ML-EAFIT/heat-computing-open-source/docs/01_evidence.md

# 01 — Evidence extraction

Short paper names: **DTM** = `data/An efficient probabilistic hardware architecture for diffusion-like models - 2510.23972v2.pdf`; **BP** = `data/A Blueprint for Equilibrium-Based … - 2607.16183v2.pdf`; **SDP** = `data/A Framework for Stochastic Differentiable Programming - 2608.01612v2.pdf`; **HF** = `data/Heat factorization.pdf`; **DF** = `data/Diffusion_Based_Integer_Factorization__….pdf`. Page numbers are PDF pages (see `docs/00_inventory.md`).

Extraction caveat: pdftotext drops decimal points in these PDFs (e.g. it prints "16 T nJ"). Every numeric value below that contains a decimal point was **checked against the rendered page image** (DTM p.6, p.25, p.29, p.38).

| Concept | What the sources say | Tag | Citation |
|---|---|---|---|
| **p-bit / probabilistic unit** | Each node of the grid "represents a single Bernoulli random variable x_i, implemented as a transistor-based sampling circuit (later referred to as RNG)". Its probability of producing 1 vs −1 "is constrained to be a sigmoidal function of an input voltage". | [DOCUMENTED] | [DTM, p.5, Sec. III] |
| p-bit (software type) | A pbit carries a distribution over two states; pdit over d states; pmode over ℝᴺ. | [DOCUMENTED] | [SDP, p.2, Sec. II A, Table I] |
| p-bit (X0 chip) | The X0 pbit outputs "a two-level random telegraph signal whose bias is approximately sigmoidal in a single control voltage". Controls are set via on-chip **8-bit DACs**. Per-site calibration error ≈5 % in absolute probability after Bayesian-optimization calibration. | [DOCUMENTED] | [SDP, p.20-21, App. D, Table II; p.9, Sec. IV B] |
| **Noise / RNG source** | "Our RNG is a digitizing comparator fed by a source of Gaussian noise… The mean of the Gaussian noise is shifted before it is sent into the comparator to implement the bias control." Built from shot-noise dynamics of subthreshold transistors. ~10 transistors, ~3 µm × 3 µm. | [DOCUMENTED] | [DTM, p.37, App. K; p.38, Fig. 15a; p.6, Sec. III; p.25, App. E] |
| RNG timing / energy | Autocorrelation decays approximately exponentially with τ0 ≈ 100 ns. Bits at τ_rng⁻¹ ≈ 10 MHz using ~350 aJ per bit. X0 pbit designs span τ0 ≈ 1 ns–1 ms. | [DOCUMENTED] | [DTM, p.6, Fig. 4b; p.25, App. E; SDP, p.20, App. D Eq. D1] |
| RNG transistor-level circuit | The noise-source circuit is delegated to Ref. [16] ("Taming nonequilibrium thermal fluctuations in subthreshold…"), which is **not in data/**. The transistor schematic of the noise source is therefore not available. | [NOT IN SOURCES] | [DTM, p.37, App. K cites [16]; SDP, p.15 ref list] |
| Gaussian comparator → sigmoid | A comparator thresholding shifted Gaussian noise gives a probit (Gaussian CDF) curve. The paper only says the measured curve is "well-approximated by a sigmoid". | [INFERRED] from App. K + Fig. 4a | [DTM, p.37 App. K; p.6 Fig. 4a caption] |
| **Bias & weight (coupling)** | Boltzmann-machine energy 𝓔(x) = −β(Σ_{i≠j} x_i J_ij x_j + Σ_i h_i x_i), x_i ∈ {−1,1} (β verified on the rendered page; pdftotext drops it). | [DOCUMENTED] | [DTM, p.5, Eq. 10] |
| Weight MAC in hardware | "A linear resistor network computes a biasing voltage given the sign-corrected neighbor states y_n = x_n ⊕ s_n". Conductances G_j set the weight magnitudes, and the sign bit s_j (XOR) sets the weight sign. Two fixed inputs (y=1, y=0) implement the bias term. V_b∞ = Σ G_j V_dd y_j / G_Σ, τ_bias = C/G_Σ. | [DOCUMENTED] | [DTM, p.25, Fig. 10; p.26, App. E.1, Eqs. E1-E7] |
| Weight storage | Model parameters must be stored in on-chip memory to set the tunable resistors; "tunable resistors do not exist", so real bias circuits are more complicated. | [DOCUMENTED] | [DTM, p.30, App. E.5 a] |
| Z1 coupling | Z1 "hardwires a degree-16 sparse interaction graph directly in silicon and executes chromatic Gibbs sweeps without FPGA mediation, communicating only h_i and J_ij between sweeps". | [DOCUMENTED] | [SDP, p.9-10, Fig. 7] |
| **Sigmoid / activation** | P(X_i[k+1]=+1 \| X[k]=x) = σ(2β(Σ_{j≠i} J_ij x_j + h_i)). | [DOCUMENTED] | [DTM, p.5, Eq. 11 (rendered page)] |
| Sigmoid (software) | P(s_i=1 \| s_nb) = σ[2γ], γ = W⁽¹⁾_i + Σ W⁽²⁾_ij s_j + … "computing simple functions of the neighbour states, multiply-accumulating the results, and then using them to generate an appropriately biased random bit". | [DOCUMENTED] | [thrml/02_spin_models.py:L21-27] |
| Sigmoid with β | π(σ_i=1 \| σ_N(i)) = 1/(1+e^{−2βℓ_i}), ℓ_i = h_i + Σ J_ij s_j. | [DOCUMENTED] | [torx/06_ising_sampling_contrastive_divergence.py:L111-121] |
| RNG bias curve | P(x_i=1) = σ(V_b/V_s − φ). | [DOCUMENTED] | [DTM, p.26, Eq. E6] |
| **Gibbs schedule (chromatic)** | DTM Boltzmann machines are bipartite (two-colourable): sample one colour block conditioned on the other, then swap. One full iteration takes ≈2τ0. K ≈ 1000 iterations typical (training). K_mix = 250 used for energy. | [DOCUMENTED] | [DTM, p.5, Sec. III; p.6, Eq. 12; p.29, Fig. 13] |
| Chromatic Gibbs (general) | Non-neighbouring nodes update in parallel, batched by colour group (Fig. 8, 3×3 grid). | [DOCUMENTED] | [DTM, p.20-21, App. C, Eq. C1-C2, Fig. 8] |
| Colouring in software | DSATUR greedy colouring into Blocks (thrml). Parity colouring of a ring (torx/06). Checkerboard on a 4×4 torus (torx/16). | [DOCUMENTED] | [thrml/02_spin_models.py:L129-160; torx/06_ising_sampling_contrastive_divergence.py:L198-208; torx/helpers/_plots_schematics.py:L1668-1674] |
| Clocking | "In practice, it is more efficient to implement standard chromatic Gibbs sampling with a global clock." The RNG "processes freely when the clock is low and latches to a state when the clock is high", then broadcasts to neighbours. | [DOCUMENTED] | [DTM, p.28, App. E.3 a; p.25, Fig. 10] |
| **Energy function** | P(x;θ) ∝ e^{−E(x,θ)} (EBM). Factorized local EBMs E = Σ ψ(·) are what the hardware samples. | [DOCUMENTED] | [DTM, p.2, Eq. 1; thrml/00_probabilistic_computing.py:L25-47] |
| Higher-order factors | thrml supports spin interactions of arbitrary order (SpinEBMFactor). | [DOCUMENTED] | [thrml/02_spin_models.py:L13, L300-304] |
| **Annealing / temperature** | Simulated annealing: log-spaced β from 0.1 to 8.0 over 4000 steps, 10 sweeps per step. "Raising β is the same as scaling the energy by β… scaling all the weights by β." | [DOCUMENTED] | [thrml/03_codon_optimization.py:L303-344] |
| Temperature sweep | 4×4 Ising cooled across β, order parameter vs exact. drive_i = β b_i and j = βJ are passed to the kernel. | [DOCUMENTED] | [torx/16_gibbs_sampling_factor_graph.py:L172-182, L592] |
| Temperature in hardware | The DTM hardware does not describe a β knob. β is absorbed into the programmed J, h (Eq. 10-11 carry a global β, but no hardware knob for it is described). The Blueprint's superconducting device tunes equilibration via temperature and potential. | [INFERRED] from DTM Eq. 11 and thrml/03 | [DTM, p.5, Eq. 11; thrml/03_codon_optimization.py:L311; BP, p.18, Sec. VIII] |
| **Readout** | Each cell supports get/set state. Initialization and readout send bits over long wires to the chip edge (E_init, E_read). Readout is a sample. Drawing it does not alter the distribution. | [DOCUMENTED] | [DTM, p.25 Fig. 10; p.28, App. E.3 b; SDP, p.17-18, App. B] |
| Readout estimators | Histograms and expectations from raw samples concentrate at a 1/√N rate. | [DOCUMENTED] | [torx/04_execution_interface_readouts.py:L98-118, L251, L321] |
| Readout via averaging | Expected values f(z) = E_{y∼π(·\|z)}[y] obtained by time-averaging or repeated runs (mean estimator Eq. 13). | [DOCUMENTED] | [BP, p.4, Sec. II D, Eqs. 12-14] |
| **Diffusion / denoising mapping** | DTM chains T EBMs. Each models P_θ(x^{t−1}\|x^t) ∝ Σ_z exp(−(E^f_{t−1}(x^{t−1},x^t) + E^θ_{t−1}(x^{t−1},z^{t−1},θ))). | [DOCUMENTED] | [DTM, p.4, Eqs. 7-8, Fig. 3] |
| Forward coupling | For discrete diffusion, E^f is one pairwise coupling per variable. As printed: 𝓔^f_{t−1} = Σ_i (Γ_i(t)/2) x^t_i x^{t−1}_i, with Γ(t) = ln[(1+(M−1)e^{−γt})/(1−e^{−γt})] (M=2 for binary). | [DOCUMENTED] | [DTM, p.23, App. D.1, Eq. D1 (rendered page); p.16, Eqs. B15, B20] |
| Forward coupling sign | Eq. B20 gives Q ∝ exp(+Σ Γ δ_{x'x}) (alignment favoured), and the text says E^f "constrains x^{t−1} to stay close to x^t". With P ∝ e^{−E} (Eq. 6-7), D1 as printed would favour anti-alignment. We therefore treat the effective coupling as **ferromagnetic, +Γ/2 on x^t x^{t−1} in the log-probability**. This reads the printed sign as a convention slip. | [INFERRED] | [DTM, p.4, Eqs. 6-7 and text; p.16, Eq. B20; p.23, Eq. D1] |
| DTCA grid | L×L grid (L=70), G12 connectivity: each connection rule (a,b) connects (x+a,y+b), (x−b,y+a), (x−a,y−b), (x+b,y−a). Random subset are data nodes x^{t−1} (N_data=834 of 4900), the rest latent. An extra node carrying x^t is attached to each data node and **stays fixed** during Gibbs. | [DOCUMENTED] | [DTM, p.5; p.24, Fig. 9, Table II; p.29] |
| Training | Monte Carlo gradient with clamped vs free phases (Eq. 14) and a total-correlation penalty (Eq. 15). Training is done on GPU simulation. | [DOCUMENTED] | [DTM, p.7, Sec. IV, Eqs. 14-15] |
| Per-pixel denoising in torx | nb07: an offline UNet supplies clean-pixel probabilities, and each pixel is one PNOT draw. **The denoiser is a NN, not an EBM.** | [DOCUMENTED] | [torx/07_discrete_diffusion.py:L1-8; torx/helpers/_nb07_diffusion.py:L1-7] |
| **Continuous variables (Gaussian / Langevin)** | Overdamped Langevin dx_i = −∂U/∂x_i dt + √(2/β) dW. Underdamped form Eq. 8. Equilibrium π ∝ e^{−βE} (Eq. 11). Elemental potentials: Gaussian U=(x−μ)²/(2σ) and double-well U=λ1 x²(x−1)² − λ2 x. | [DOCUMENTED] | [BP, p.3, Eq. 7; p.4, Eqs. 8-11; p.6, Eqs. 19-20] |
| Double-well ≈ p-bit | "a double well thermodynamic neuron can be converted into a probabilistic-bit". Implemented with superconducting Josephson-junction circuits; ambient thermal fluctuations are the noise. | [DOCUMENTED] | [BP, p.18, Sec. VIII] |
| Gaussian-Bernoulli EBM | Continuous v_i ~ N(b_i + σ_i² Σ W_ij h_j, σ_i²). Binary h_j ~ σ(2(Σ v_i W_ij/σ_i² + c_j)). Continuous messages are costly to pass in hardware. | [DOCUMENTED] | [DTM, p.23, App. C.1 b, Eqs. C11-C13] |
| Langevin in torx | LangevinGate: x' = x − ε∇V + √(2Tε) ξ on a soft-spin quartic Ising energy, s=tanh(x). Optional MALA accept/reject. | [DOCUMENTED] | [torx/helpers/_langevin.py:L46-143; torx/12_langevin_graph_ising.py:L92-126] |
| pmode hardware | X0 pmode = network of capacitively coupled CMOS inverters (NEAT-RN). Gaussian primitive correlation time ≈1 ns, ≈15 aJ per sample. | [DOCUMENTED] | [SDP, p.20-21, App. D] |
| Gaussian gates | Affine Gaussian gate X → MX + d + ε, ε∼N(0,Δ). Ornstein–Uhlenbeck gate. | [DOCUMENTED] | [SDP, p.6, Eq. 24; p.18, App. C; torx/10_pmode_gaussian_gates.py:L166] |
| **Probabilistic gates** | PNOT(p), PSWAP(p), PCNOT(p), PReset(p), PJUMP, PDEMUX, PCopy, PIsing. All except PIsing have the form (1−p)I + pB. | [DOCUMENTED] | [SDP, p.6, Eqs. 18-23; p.17, App. A] |
| Logic via energy | "we can express conditional relationships between variables, such as logical AND/OR/NOT [49]" by composing energy functions. No explicit AND/OR energy is given in data/. | [DOCUMENTED] (claim) / [NOT IN SOURCES] (the specific gadget) | [BP, p.3, Sec. II A] |
| **Factorization / heat kernels** | Factor N via discrete-time heat diffusion on a graph, O((log N)²) diffusion steps. RC network C dV/dt = −LV implements heat flow. Integer prototype c_{t+1}(x) = 2c_t(x) + c_t(x b^{2^t}) + c_t(x b^{−2^t}) "for a small FPGA… a verification platform, not a fast large-integer factoring machine". | [DOCUMENTED] | [HF, p.1 abstract; DF, p.63, Sec. 17, Eq. 17.1; p.71, Sec. 19.6, Eq. 19.4] |
| Factorization hardware status | The monograph's RTL "has not been synthesized or simulated with an HDL toolchain". "No hardware speedup or manufacturing feasibility is asserted without synthesis and measurements." | [DOCUMENTED] | [DF, p.75; p.1 abstract] |
| **System platform** | XTR-0 = CPU host + FPGA + socketed X0 chip. The FPGA mediates data and control, so topology and schedule are software-defined. | [DOCUMENTED] | [SDP, p.9, Fig. 6; p.20, App. D a] |
| **Energy model** | E = T·K_mix·L²·E_cell, E_cell = E_rng + E_bias + E_clock + E_comm ≈ 2 fJ (main text). Fig. 12b breakdown: total ≈1.6 fJ, dominated by neighbour communication. DTM total ≈1.6·T nJ. ~10,000× less energy than GPU on binarized Fashion-MNIST (system-level estimate). | [DOCUMENTED] | [DTM, p.6, Eqs. 12-13; p.29, Fig. 12b; p.1 abstract] |

## Consequences for the FPGA design (all [FPGA-APPROX])

1. One p-bit = **MAC over ±J (XOR sign) + bias → sigmoid → compare with noise → latch**. This mirrors Fig. 10 of DTM [DTM, p.25]. The digital MAC needs no multiplier because x_j ∈ {−1,+1}: each term is +J or −J, which is the digital equivalent of the XOR sign-correction y = x ⊕ s.
2. The RNG becomes an LFSR (pseudo-random uniform word). The Gaussian-comparator physics [DTM, p.37] becomes `rand < sigmoid(logit)`, an inverse-CDF comparison. The two give the same Bernoulli law when the LUT holds the exact target probability.
3. Chromatic (2-colour) scheduling as in DTM/torx. Our FPGA time-multiplexes the p-bit cell instead of having one physical cell per node.
4. β is handled as in thrml/03: a schedule multiplies the local field before the sigmoid.
5. The denoising demo is **feasible** at toy scale. DTM gives the forward coupling Γ(t)/2 and the clamped x^t nodes. It does **not** give trained weights for small grids, so the marginal-energy weights in our demo are hand-set (Hebbian pattern storage). That is an [FPGA-APPROX] choice, not Extropic's model.
