ML-EAFIT/heat-computing-open-source/task.md

Has ingenieria inversa de que pasa detras de un computador termodinamico de extropic

creame un codigo en verilog para testiarlo
dame las unidades basicas, por ejemplo en computacion normal son las compuertas and or not, cuales son en termodinamica, hay blqoues como alu, flip flops, cuales son en computacion termica

Dame los diagramas de cada bloque, como se conectan los bloques termodinamicos

dame un codigo en verilog usando cada bloque ,

la idea despues es meter esto en una fpga tang nano 9, sabiendo lo que hacemos
