ML-EAFIT/heat-computing-open-source/docs/img/hist_grid16.png

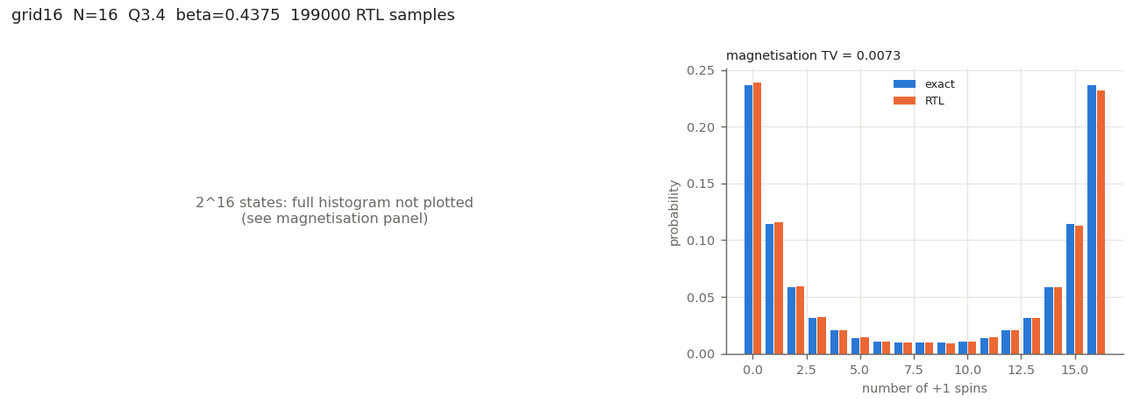
docs/img/hist_grid16.png
