ML-EAFIT/heat-computing-open-source/docs/img/hist_ring8.png

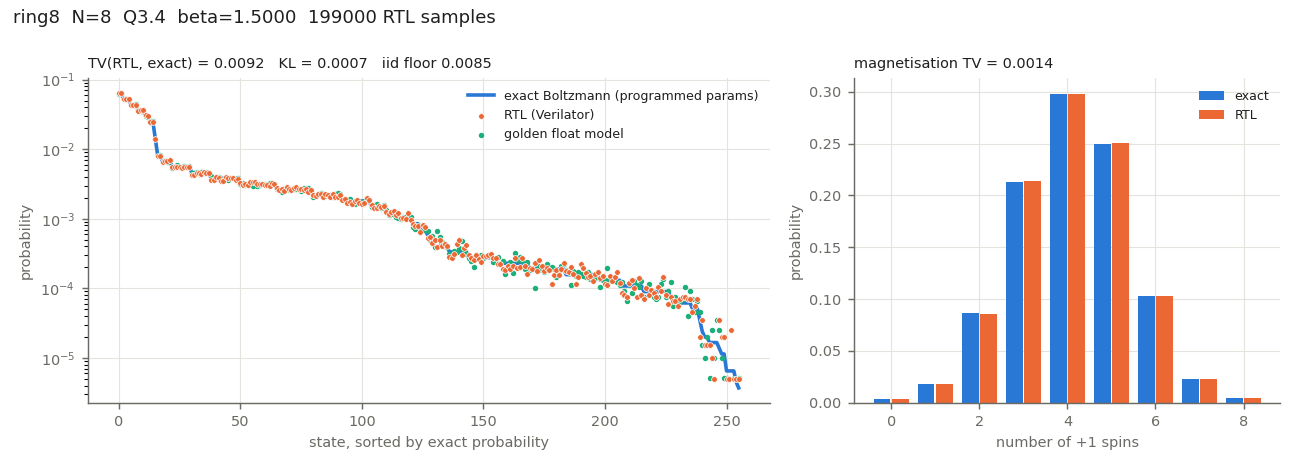
docs/img/hist_ring8.png
