ML-EAFIT/heat-computing-open-source/docs/img/pgate_fulladder.png

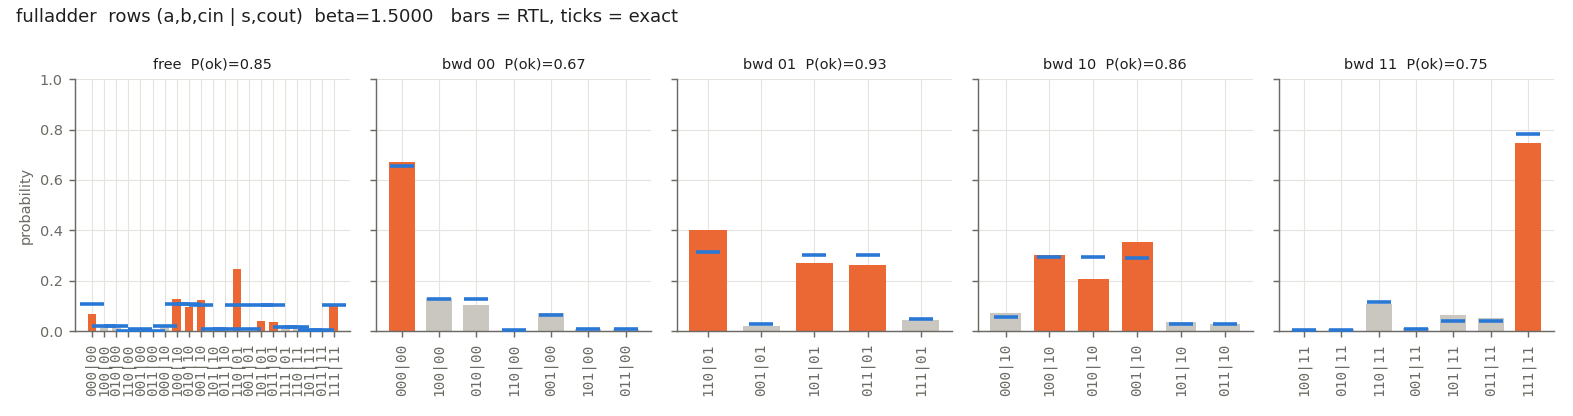
docs/img/pgate_fulladder.png
