ML-EAFIT/heat-computing-open-source/docs/img/pgate_xor.png

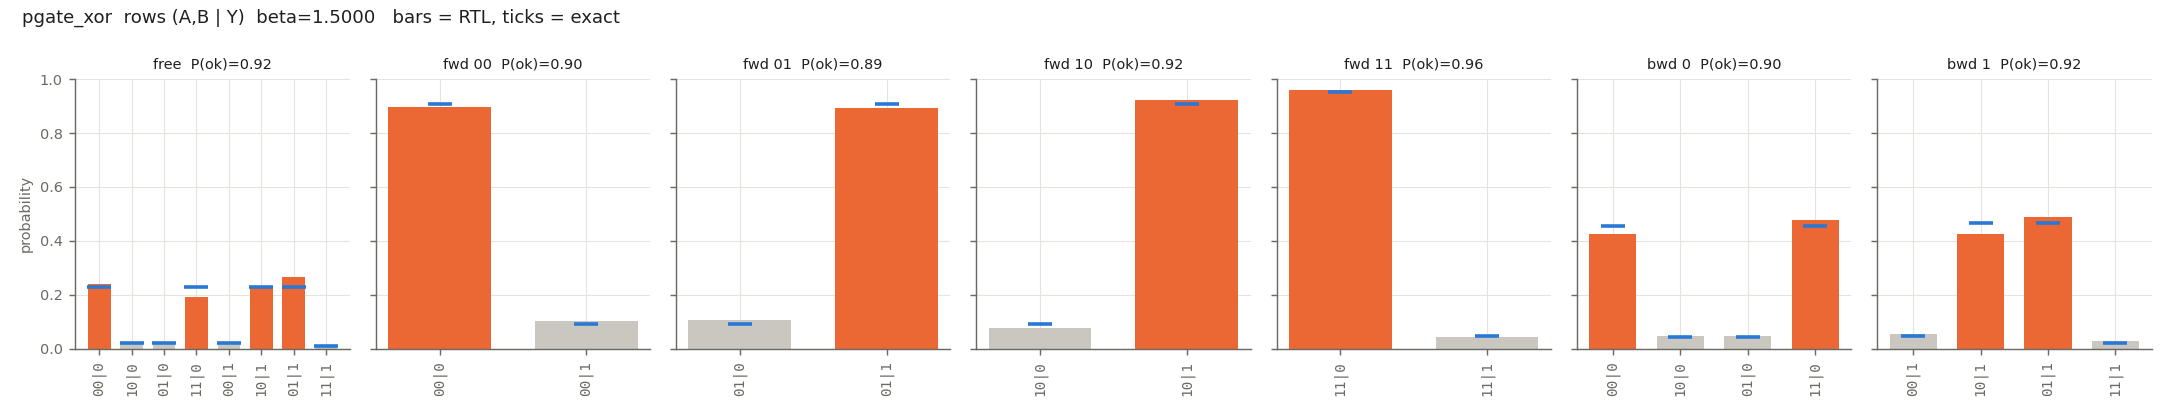
docs/img/pgate_xor.png
