ML-EAFIT/heat-computing-open-source/docs/02_building_blocks.md

# 02 — Building blocks: classical ↔ thermodynamic

Short paper names as in `docs/01_evidence.md` (DTM, BP, SDP, HF, DF).

## 1. Mapping table

| Classical block | Thermodynamic / probabilistic counterpart | What it does | Physical implementation per the sources | FPGA equivalent (this repo) |
|---|---|---|---|---|
| NOT / AND / OR gate (deterministic Boolean map) | **Probabilistic gates**: PNOT(p), PCNOT(p), PSWAP(p), PReset(p), PCopy(p), PIsing(θ). Each is a stochastic matrix, (1−p)I + pB [DOCUMENTED, SDP p.6 Eqs. 18-20; p.17 App. A]. At p∈{0,1} they reduce to deterministic gates [DOCUMENTED, SDP p.17]. | Transforms a probability distribution, not a value. | On XTR-0 the FPGA routes register values according to the outcome of a pbit programmed to p [DOCUMENTED, SDP p.9 Sec. IV B]. Energy-composed AND/OR/NOT are mentioned but not specified [DOCUMENTED claim, BP p.3; gadget NOT IN SOURCES]. | **Built as p-gates** (`rtl/pgates.v`, `model/pgates.py`): p-NOT, p-AND, p-OR, p-XOR as small Ising problems whose ground states are the truth table, composable and runnable backwards by clamping. Bit-exact vs model, truth tables verified (docs/05) [NOT IN SOURCES: standard Ising gadget coefficients]. A **p-bit with bias only** (J=0) is PNOT-from-zero with p = σ(2βh) [INFERRED from torx/06_ising_sampling_contrastive_divergence.py:L123-128]. |
| Transistor / logic cell | **p-bit (sampling cell)** | Outputs ±1 with P(+1) = σ(2β(ΣJ_ij x_j + h_i)) [DOCUMENTED, DTM p.5 Eq. 11]. | All-transistor RNG: Gaussian shot noise + control-voltage shift → comparator [DOCUMENTED, DTM p.37 App. K, p.38 Fig. 15a]. ~10 transistors, 3×3 µm [DOCUMENTED, DTM p.25]. | `rtl/pbit.v`: field → ×β → sigmoid LUT → `rand16 < p` → bit [FPGA-APPROX]. |
| Clock oscillator / entropy-free logic | **Noise source (RNG)** | Supplies fresh randomness. Decorrelation time τ0 ≈ 100 ns sets the sampling rate [DOCUMENTED, DTM p.6 Fig. 4b]. | Subthreshold-transistor shot noise [DOCUMENTED, DTM p.6]. The transistor-level noise circuit is in an external reference [NOT IN SOURCES]. | `rtl/lfsr.v`, `rtl/noise_bank.v`: 32-bit Galois LFSRs leaping 16 steps per draw. Optional ring-oscillator XOR (non-simulatable) [FPGA-APPROX]. |
| Multiplier / adder tree (ALU datapath) | **Synapse / weight MAC** (bias network) | Computes the local field ℓ_i = h_i + Σ_j J_ij x_j. | Linear resistor network. Conductance G_j sets the magnitude, and XOR with the sign bit s_j gives y_j = x_j ⊕ s_j. Two fixed inputs (1, 0) give the bias. The node relaxes with τ_bias = C/G_Σ [DOCUMENTED, DTM p.25 Fig. 10; p.26 Eqs. E1-E7]. | `rtl/weight_mac.v` / `rtl/coupling_row.v`: serial accumulate of ±J_ij (the sign of x_j selects add or subtract, **no multiplier**) [FPGA-APPROX, mirrors the XOR trick]. |
| Constant register / immediate | **Bias h_i** | Shifts a p-bit's preference. | Fixed resistor inputs y_{n+1}=1, y_{n+2}=0 [DOCUMENTED, DTM p.26]. | Bias RAM entry added as the MAC start value [FPGA-APPROX]. |
| Interconnect / bus | **Coupling network** (graph J) | Defines which p-bits see each other. | Regular grid with G8–G24 skip patterns [DOCUMENTED, DTM p.24 Table II]. Z1: hardwired degree-16 graph [DOCUMENTED, SDP p.9-10 Fig. 7]. XTR-0: topology set in software via the FPGA [DOCUMENTED, SDP p.9 Fig. 6]. | Dense N×N weight RAM in BSRAM. Zero entries mean "no edge" [FPGA-APPROX]. |
| Accumulator register | **Field accumulator** | Holds the running ℓ_i during the MAC. | Analog: the node voltage V_b on capacitor C [DOCUMENTED, DTM p.26 Eq. E1]. | Signed AW-bit register, sized so it cannot overflow [FPGA-APPROX]. |
| Comparator | **Comparator** (noise vs threshold) | Turns a continuous level into a bit. | Subthreshold comparator digitizing shifted Gaussian noise [DOCUMENTED, DTM p.37]. | `rand16 < p16` in `pbit.v` [FPGA-APPROX]. |
| Lookup / function unit | **Sigmoid (activation)** | Maps field → probability. | Intrinsic to the RNG's response to its control voltage, measured to be ≈ sigmoidal [DOCUMENTED, DTM p.6 Fig. 4a; SDP p.20 App. D]. | `rtl/sigmoid_lut.v` (1024×16 ROM in BSRAM) or `rtl/sigmoid_pwl.v` (piecewise linear, shifts only) [FPGA-APPROX]. |
| Flip-flop | **Latched spin state** | Holds x_i between updates. | The RNG "processes freely when the clock is low and latches to a state when the clock is high" [DOCUMENTED, DTM p.25 Fig. 10]. | Spin register bit `s[i]` in `pbit_array.v` [FPGA-APPROX]. |
| Clock + control FSM (program counter) | **Update scheduler** (chromatic Gibbs) | Updates colour blocks in turn. One sweep ≈ 2τ0 for a bipartite graph [DOCUMENTED, DTM p.5]. A global clock is preferred over asynchronous updates [DOCUMENTED, DTM p.28]. | Global clock tree [DOCUMENTED, DTM p.28 E.3a]. | Order ROM (colour 0 nodes, then colour 1, …). One p-bit update per slot, time-multiplexed [FPGA-APPROX]. |
| Clock frequency / voltage scaling | **Annealing controller** (β schedule) | Raises β over time to find low-energy states. | Software: log-spaced β, "scaling all the weights by β" [DOCUMENTED, thrml/03_codon_optimization.py:L311-334]. No on-chip β knob is described for DTCA [INFERRED, DTM p.5 Eq. 11]. | `rtl/schedule_ctrl.v`: constant, linear or table (geometric) β in Q4.4 [FPGA-APPROX]. |
| RAM | **Weight memory** | Stores J, h. | Parameters stored on-chip to program the resistors, with maintenance-dominated cost [DOCUMENTED, DTM p.30 E.5a]. X0 controls via 8-bit DACs [DOCUMENTED, SDP p.20]. | BSRAM, 8-bit signed Q3.4 [FPGA-APPROX]. |
| I/O port / logic analyzer | **Readout** (get/set state, histograms) | Turns samples into estimates. | get/set-state lines per cell, long wires to the chip edge [DOCUMENTED, DTM p.25 Fig. 10; p.28 E.3b]. Readout estimators concentrate as 1/√N [DOCUMENTED, torx/04_execution_interface_readouts.py:L251, L321]. | `rtl/readout_counter.v`: per-spin "up" counters + full-state histogram (N ≤ 12) [FPGA-APPROX]. |
| Host bus (PCIe, …) | **Host interface** | Programs J, h, schedule. Reads samples. | XTR-0: CPU host + FPGA + chip [DOCUMENTED, SDP p.9 Fig. 6]. Z1: host sends h_i, J_ij between sweeps [DOCUMENTED, SDP p.9]. | `rtl/uart_rx.v`, `rtl/uart_tx.v`, command FSM in `rtl/top.v` (115200 8N1 over the Tang Nano's BL702 USB-UART) [FPGA-APPROX]. |
| Analog-domain primitive (op-amp integrator) | **pmode / Langevin node** (continuous variable) | Gaussian or double-well variable relaxing under Langevin dynamics [DOCUMENTED, BP p.3 Eq. 7; p.6 Eqs. 19-20]. | Superconducting double-well "thermodynamic neuron" [DOCUMENTED, BP p.18]. X0 pmode = capacitively coupled CMOS inverters (NEAT-RN) [DOCUMENTED, SDP p.21]. | **Built** (2026-10-30): `rtl/pmode_array.v`, M ≤ 16 Langevin soft spins x' = x − ε∇V + √(2Tε)ξ, the torx `LangevinGate` energy with tanh from the p-bit sigmoid LUT and ξ from an inverse-CDF Gaussian table. Bit-exact with `model/pmode.py`, histograms vs exact e^{−V/T} in docs/06 §11 [FPGA-APPROX: fixed point, ULA without Metropolis]. |
| Swap / exchange unit (no classical twin; closest is a speculative-execution select) | **Replica exchange** (parallel tempering) | Runs K copies at a ladder of β and swaps neighbours, so the cold copy escapes local minima. | Not described for the hardware. Annealing by β is [DOCUMENTED, thrml/03]. | `rtl/temper_ctrl.v`: the swap test is **itself a p-bit**, with field = energy difference, β = ladder gap and P(swap) = σ(2Δβ·ΔE/2). Energies are tracked from the array's update tap (docs/06 §9) [FPGA-APPROX]. |
| Training loop / backprop hardware | **Contrastive learning** (positive / negative phase) | Moves J, h along ⟨s_i s_j⟩_data − ⟨s_i s_j⟩_model. | Host-side training of the EBMs [DOCUMENTED, DTM p.7 Eqs. 14-15; thrml/02; torx/06]. | `model/train.py` + `host.py train`: the chip is the sampler and the host does the gradient. Learns AND (rediscovers the docs/05 gadget), XOR with one hidden unit, and recovers ring8 (docs/06 §10) [FPGA-APPROX]. |
| Clock jitter / metastability spec | **RNG correlation time τ0, cross-cell noise correlation** | Sets how fast fresh randomness arrives and whether neighbours share it. | τ0 ≈ 100 ns [DOCUMENTED, DTM p.6 Fig. 4b]. | `sparse_array.v` NOISE_CTL: persistence q (lazy update: same law, τ_int ∝ 1/q) and shared lanes (biases the law) (docs/06 §8) [FPGA-APPROX]. |

## 2. How the blocks are composed

### 2.1 Sampling cell = the "gate" of thermodynamic computing
Per DTM Fig. 10 [DOCUMENTED, DTM p.25], one cell is made of:

`neighbour states x_j ─XOR s_j→ resistor network (Σ G_j y_j) → V_b → RNG (sigmoidal bias) → latch on clock → broadcast to neighbours`

In this repo the same dataflow is time-multiplexed through one `pbit.v` engine [FPGA-APPROX].

### 2.2 Boltzmann machine / Ising array
- An array of cells on a sparse local graph, with a 2-colour (bipartite) schedule [DOCUMENTED, DTM p.5]. Layers in a deep Boltzmann machine are just subsets of grid nodes (data vs latent) chosen at random [DOCUMENTED, DTM p.24 App. D.2].
- Equivalent software: thrml `IsingEBM` + colour Blocks [DOCUMENTED, thrml/02_spin_models.py:L69-94, L129-160]. torx chromatic PNOT [DOCUMENTED, torx/06_ising_sampling_contrastive_divergence.py:L194-301].
- **Systematic-scan validity:** any fixed visiting order of single-site Gibbs updates leaves the Boltzmann distribution invariant. Within one colour class, sequential updates equal the parallel block update, because same-colour nodes are conditionally independent [INFERRED from DTM p.21 App. C "any two nodes that are not neighbors [can be] updated in parallel"]. This is why our sequential engine reproduces chromatic Gibbs exactly.

### 2.3 Denoising step (DTM)
One DTM step is an EBM over (x^{t−1}, z^{t−1}) with the clamped previous output x^t coupled pairwise to each data node [DOCUMENTED, DTM p.4 Eq. 8, Fig. 3c; p.24 Fig. 9b]. Chaining T such EBMs gives the reverse process [DOCUMENTED, DTM p.4 Eq. 5, Fig. 3b]. The chain can run on distinct circuitry or on the same hardware reprogrammed between steps [DOCUMENTED, DTM p.5].

In hardware terms, clamping x^t adds a per-node bias (Γ_t/2)·x^t_i to h_i. A clamped neighbour contributes a constant to the field [INFERRED from Eq. 11 + Eq. D1]. `rtl/denoise_demo.v` uses exactly this: it rewrites the bias RAM between steps [FPGA-APPROX].

### 2.4 Optimization by annealing
Max-Cut and other Ising-encodable problems: sample while raising β [DOCUMENTED, thrml/03_codon_optimization.py:L303-344]. For Max-Cut, the cut equals Σ_{(i,j)∈E} (1 − s_i s_j)/2 [DOCUMENTED, torx/helpers/_nb09_maxcut.py:L52-60]. Choosing J_ij = −w_ij (antiferromagnetic) makes low energy equal a large cut [INFERRED from the cut formula + Eq. 10].

### 2.5 "Probabilistic ALU" gadgets in the sources
- **Gate circuits (PSC):** layers of gates with disjoint supports run in parallel, and layers compose in series [DOCUMENTED, SDP p.5 Eqs. 14-16]. Mixture-of-Gaussians = ancilla pdit + controlled shift + discard [DOCUMENTED, SDP p.6 Eq. 27].
- **Diffusion / random walks:** one PSWAP per edge, Trotterized, gives graph heat flow [DOCUMENTED, SDP p.7, p.10; torx/02_random_walks_on_graphs.py:L136].
- **Integer factorization by heat diffusion:** discrete-time heat kernel on a Cayley graph [DOCUMENTED, HF p.1, p.5]. The physical primitive is an RC network implementing exp(−tL/C) [DOCUMENTED, DF p.63 Eq. 17.1]. The small-FPGA prototype is an exact integer update c_{t+1}(x) = 2c_t(x) + c_t(x b^{2^t}) + c_t(x b^{−2^t}) [DOCUMENTED, DF p.71 Eq. 19.4]. The author describes it as "a verification platform, not a fast large-integer factoring machine" [DOCUMENTED, DF p.71]. **Not built here.** It is deterministic integer arithmetic, not a p-bit block, and the monograph's own RTL is unsynthesized [DOCUMENTED, DF p.75].
- **Logic gates via energy composition (AND/OR/NOT):** mentioned [DOCUMENTED, BP p.3], but no energy coefficients are given in data/ [NOT IN SOURCES]. We built them anyway with the standard Ising gadgets (plus a brute-forced XOR with one auxiliary p-bit), composed them into a full adder and a 2×2 multiplier, and ran the multiplier backwards to factor 6, 3, 9 and 4 on the RTL. See docs/04 §3-4 (pictures) and docs/05 (results). The coefficients remain ours, not the papers'.
