ML-EAFIT/heat-computing-open-source/tb/build/noise_tau.png

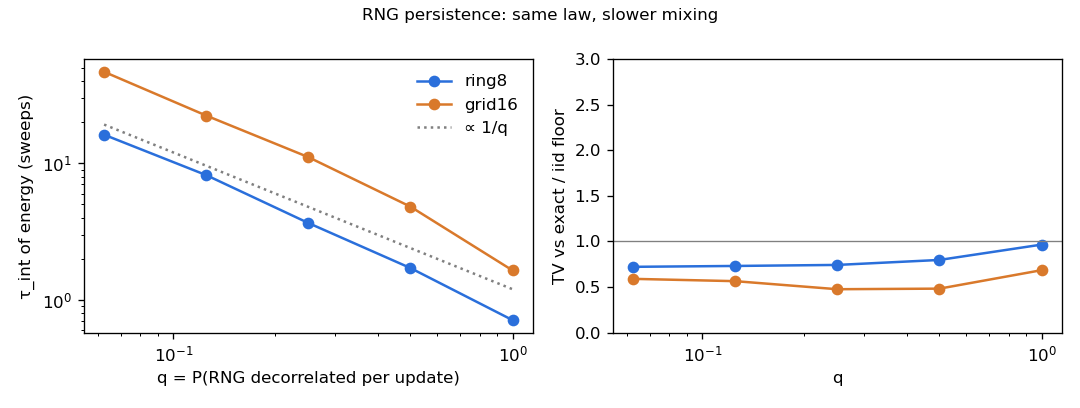
tb/build/noise_tau.png
