ML-EAFIT/heat-computing-open-source/tb/build/pgate_factor6_pt.png

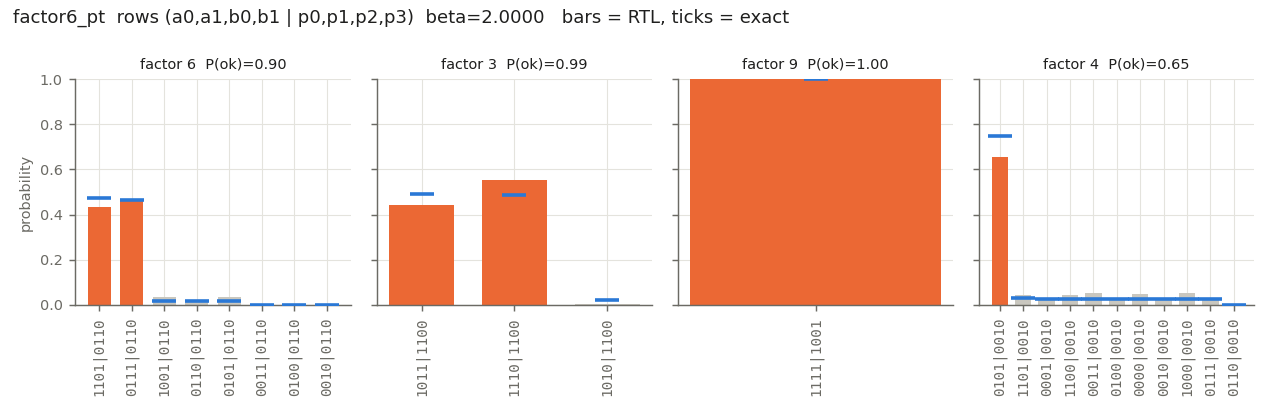
tb/build/pgate_factor6_pt.png
