ML-EAFIT/heat-computing-open-source/tb/build/pgate_not.png

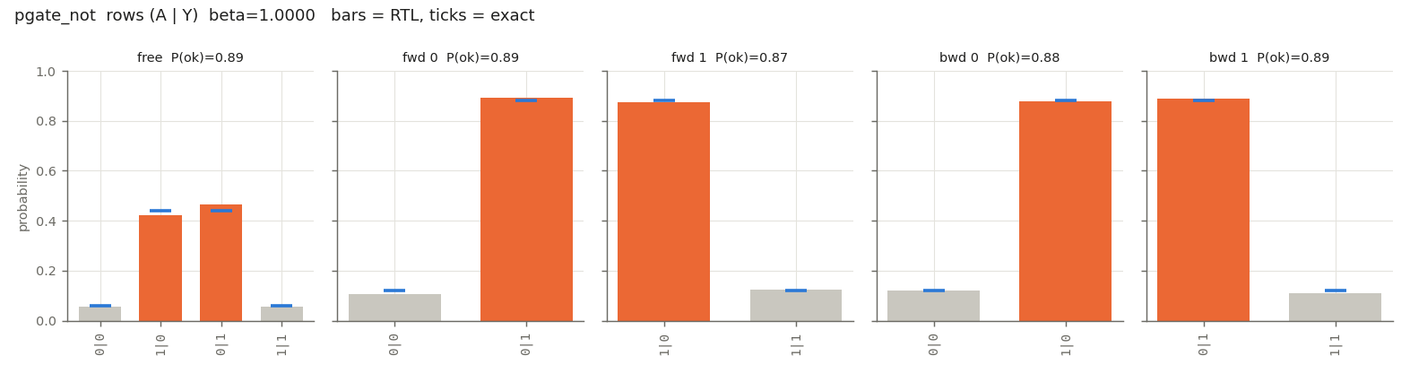
tb/build/pgate_not.png
