ML-EAFIT/heat-computing-open-source/tb/build/pgate_or.png

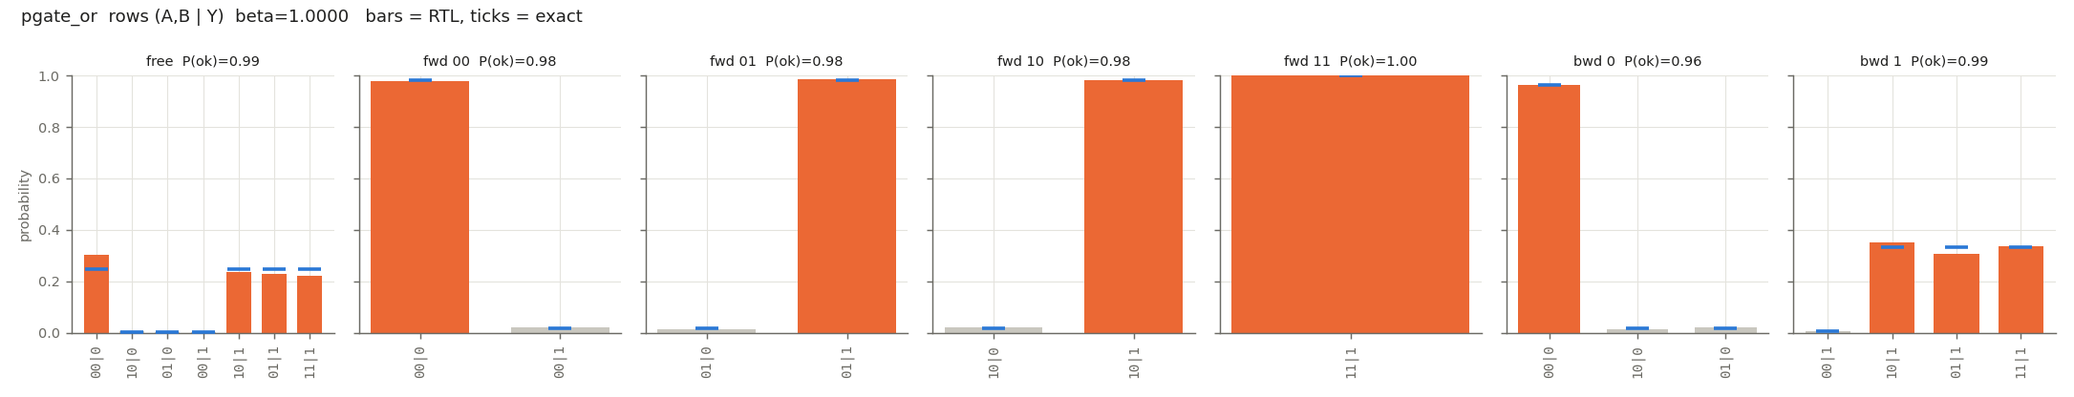
tb/build/pgate_or.png
