ML-EAFIT/heat-computing-open-source/tb/build/pmode_hist.png

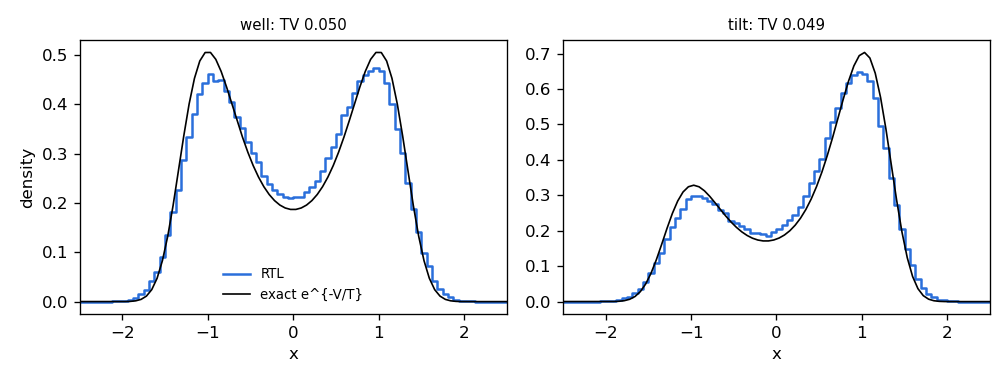
tb/build/pmode_hist.png
