ML-EAFIT/heat-computing-open-source/tb/build/train_kl.png

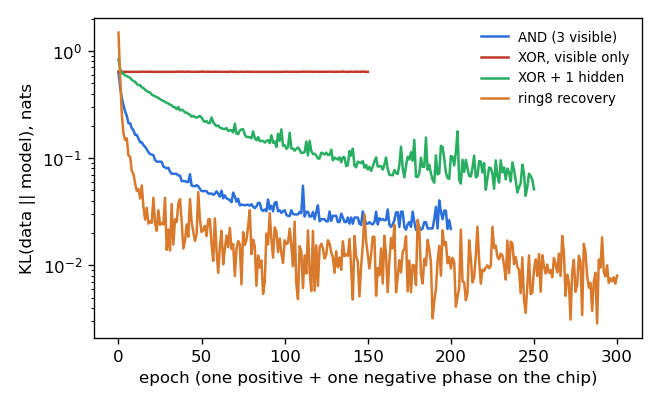
tb/build/train_kl.png
